Triangle-Lab-3DP/PUP-board/README.md

# PUP Project README

## Introduction

"PUP" is a control board specifically designed for MMU (Multi-Material Unit) systems like [EMU](https://github.com/DW-Tas/EMU) , where each channel requires an independent controller. Of course, you can use it for any other project you wish.

### Specifications

  * **Main Chip**: RP2040 133mhz.
  * **Connectivity**: Dual power connectors and dual CAN interfaces for convenient daisy-chaining.
  * **Drivers**: 1 x Onboard TMC2226 (TMC2209 in different packages) stepper driver.
  * **Dedicated Interfaces**: 1 x 8-pin XH2.54 connector is provided for direct connection to the EMU Hatch Board.
  * **Lighting**: 2 x Neo pixel RGB interfaces, one of which is integrated into the 8-pin XH2.54 connector.
  * **IO Expansion**:
      * 8 x I/O connectors, two of which are integrated into the 8-pin XH2.54 connector.
      * 3 x I2C interfaces.
      * 1 x SPI (AUX) interfaces.
  * **Outputs & Sensors**:
      * 2 x 24V Fans Output (1A max).
      * 1 x Heater output, 5A max.
      * 1 x NTC temperature sensor interface for temperature monitoring.
      * 1 x ADC pin for PSF Sensor.
  * **Power Output**: The 5V/3A output can drive larger servos.






### Simplified Wiring & Precautions

The PUP board features integrated CAN bus and power I/O ports designed for daisy-chain expansion, significantly streamlining your wiring layout.

> **⚠️ Terminating Resistor Note:**  
> The CAN bus requires a 120Ω terminating resistor connected in parallel at both ends of the link. You need to install a jumper with a 120-ohm resistor on the last PUP board; none of the intermediate ones require it.


> **⚠️ Power Limit Warning:**  
> When daisy-chaining power across multiple PUP boards, the total combined output current must never exceed **5A**. Avoid using high-power heating outputs in this configuration. If you need to drive heaters on multiple boards simultaneously, you must wire their power inputs in parallel directly to the main power supply.

## Pin Map


## Getting Started

PUP boards ship pre-flashed with the Katapult bootloader and Klipper firmware. Once the boards are correctly wired and powered on, they are ready for use, and the RUN LED will remain solidly lit.

### 1\. Host Configuration

Please ensure that the CAN bus interface on your Klipper host is configured and the speed is set to 1,000,000.

### 2\. Querying UUIDs

Executing the `canbus_query` command will display the UUIDs of all connected PUP boards:

``` bash
~/klippy-env/bin/python ~/klipper/scripts/canbus_query.py can0

```


### 3\. Lane Mapping

To map a specific UUID to its physical lane (e.g., Lane 0), follow these steps:

1.  Double-click the **RST** button on the target board. The **RUN LED** will begin blinking.
 

2.  Re-run the `canbus_query` command. The application mode for this specific board's UUID will now display as **CanBoot** (or **Katapult**).
 

3.  Record this UUID, then repeat the process for the remaining boards to map every lane.

## License

This project is licensed under the MIT License - see the LICENSE file for details.
