Triangle-Lab-3DP/PUP-board/TL_PUP_v1.0b_Pin_Map.pdf

Vin
/Vout

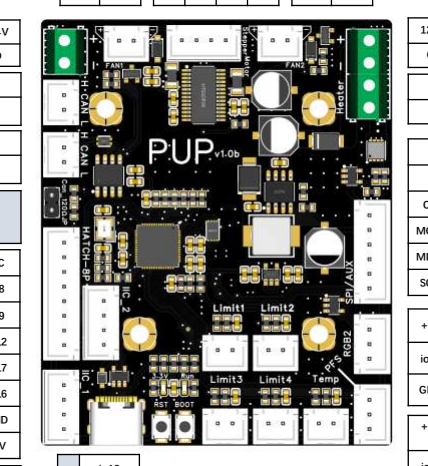
[picture p1: figure]

12-24V

GND

CAN Bus
Termination
resistor jumper

Fan1

Vin io10

Fan2

Vin io11

12-24V
Vin
/Vout GND

Vin
Heater
io20
CAN H | RX io4
CAN L | TX io5
| NC
LED | io8
PRE | io9
POST | io12
SDA | io17
SCL | io16
GND | GND
+5V | +5V IIC_1

io17

io16

GND

+5V

Limit1

io25 GND

Limit2

io24 GND

Limit3/TEMP

io26 GND

Limit4/TEMP

io26 GND

TEMP

io28 GND

IIC_2

io18

io19

GND

+5V

GND

+5V

SPI/AUX
CS | io1
MOSI | io0
MISO | io3
SCK | io2

+5V

RGB2
io23

GND

+3.3 V

PFS in
io29

GND

TMC2209 Driver

EN | io7
DIR | io6
STEP | io15
UART | io13

Stepper Motor

A1 | A2 | B1 | B2
CAN H | RX io4
CAN L | TX io5

# PUP v1.0b Pin out
