Triangle-Lab-3DP/PUP-board/3D CAD/TL_PUP_IO_Board_for_EMU/TL_PUP_IO_Board_Mount_for_EMU.STEP

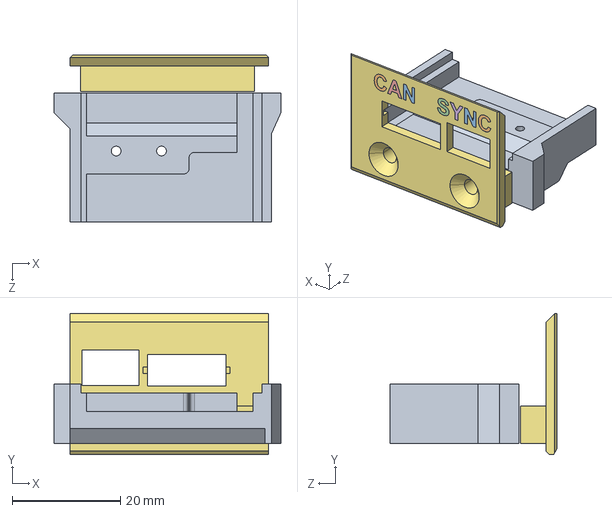
[picture p2: CAD file, 2026-07-31]
3D CAD/TL_PUP_IO_Board_for_EMU/TL_PUP_IO_Board_Mount_for_EMU.STEP
42.0 x 26.1 x 30.8 mm
[a]_Cable Entry - IO Board Inner
[a]_Cable Entry - IO Board OutSide (1)
