Triangle-Lab-3DP/PUP-board/3D CAD/TL_PUP_v1.0b_Mount_for_EMU.STEP

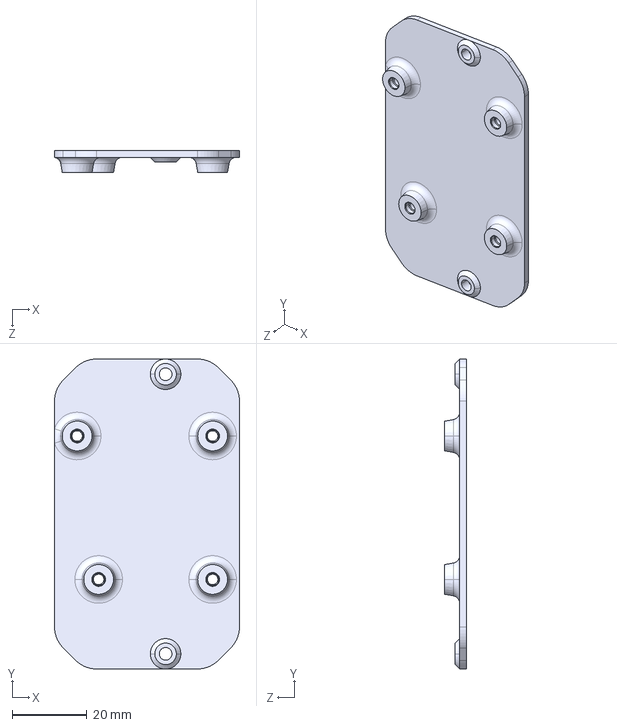
[picture p3: CAD file, 2026-07-31]
3D CAD/TL_PUP_v1.0b_Mount_for_EMU.STEP
49.6 x 83.2 x 5.80 mm
