Triangle-Lab-3DP/PUP-board/3D CAD/TL PUP board v1.0b.step

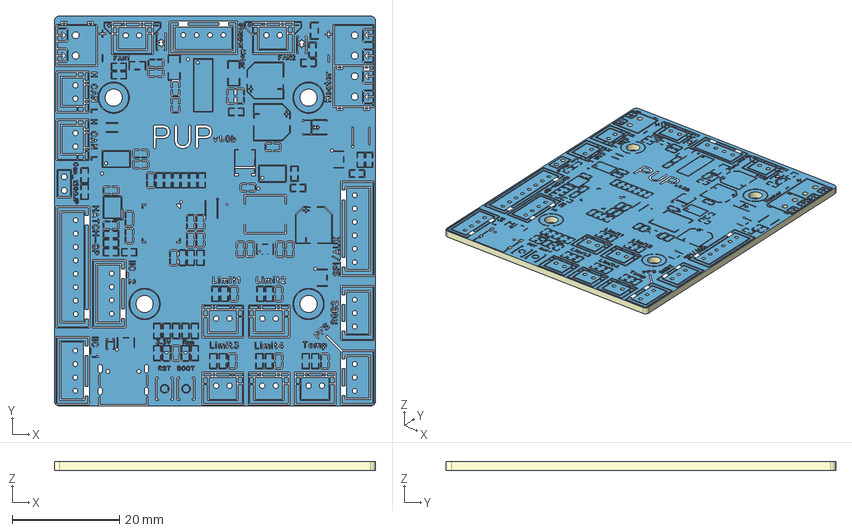
[picture p4: CAD file, 2026-07-31]
3D CAD/TL PUP board v1.0b.step
59.9 x 72.7 x 1.64 mm
Board~YmwZ
TopCopper~YmwZ
BottomCopper~YmwZ
TopSilkscreen~YmwZ x 400
BottomSilkscreen~YmwZ x 472
TopFpcStiffener~YmwZ
BottomFpcStiffener~YmwZ
