Triangle-Lab-3DP/PUP-board/3D CAD/TL_PUP_IO_Board_for_EMU/TL_PUP_IO_Board_for_EMU.step

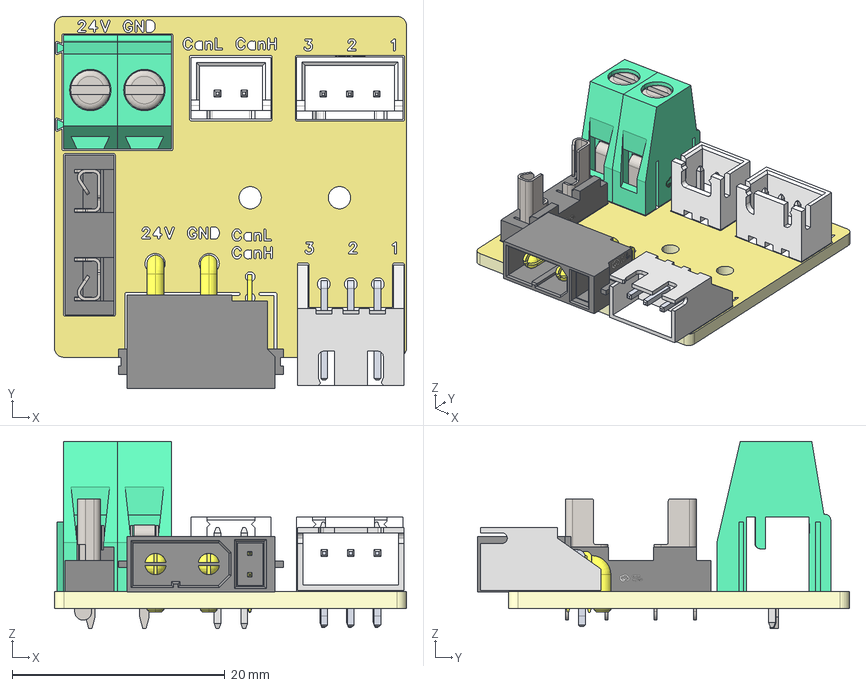
[picture p5: CAD file, 2026-07-31]
3D CAD/TL_PUP_IO_Board_for_EMU/TL_PUP_IO_Board_for_EMU.step
33.1 x 34.9 x 17.6 mm
Board~be1W
TopCopper~be1W
BottomCopper~be1W
TopSilkscreen~be1W x 41
BottomSilkscreen~be1W x 8
TopFpcStiffener~be1W
BottomFpcStiffener~be1W
CONN-TH_2P-P2.50_HX-2.54MM-2P-ZZ-MS~CONN-TH_2P-P2.50_HX-2.54MM-2P-ZZ-MS~HvNi
CONN-TH_3P-P2.50_HX25003-3WAG~CONN-TH_3P-P2.50_HX25003-3WAG~Ir1W
CONN-TH_4P-XT30PW-M~CONN-TH_4P-XT30PW-M~onUg
CONN-TH_3P-P2.50_HC-XH-3A-G~CONN-TH_3P-P2.50_HC-XH-3A-G~TdX0
FUSE-TH_XF-505P~FUSE-TH_XF-505P~nJp9
CONN-TH_P5.08_KF128-5.08-2P~CONN-TH_P5.08_KF128-5.08-2P~UoZI
