Triangle-Lab-3DP/PUP-board/Happy-Hare config/emu_macros.cfg

# === EMU Lane Temperature and Humidity Sensors ===

# AHT20 Sensor definitions below. Uncomment to enable either the BME or AHT sensor definitions depending
# on your hardware setup.
[temperature_sensor Lane_0]
sensor_type: AHT2X
aht10_report_time: 20
i2c_address: 56
i2c_mcu: mmu0
# SW I2C
i2c_software_scl_pin: mmu0:gpio16  # SLB: PB10
i2c_software_sda_pin: mmu0:gpio17  # SLB: PB11
# HW I2C
# i2c_bus: i2c3_PB3_PB4 # EBB
# i2c_bus: i2c2_PB10_PB11 # SLB

[temperature_sensor Lane_1]
sensor_type: AHT2X
aht10_report_time: 20
i2c_address: 56
i2c_mcu: mmu1
# SW I2C
i2c_software_scl_pin: mmu1:gpio16  # SLB: PB10
i2c_software_sda_pin: mmu1:gpio17  # SLB: PB11
# HW I2C
# i2c_bus: i2c3_PB3_PB4 # EBB
# i2c_bus: i2c2_PB10_PB11 # SLB

[temperature_sensor Lane_2]
sensor_type: AHT2X
aht10_report_time: 20
i2c_address: 56
i2c_mcu: mmu2
# SW I2C
i2c_software_scl_pin: mmu2:gpio16  # SLB: PB10
i2c_software_sda_pin: mmu2:gpio17  # SLB: PB11
# HW I2C
# i2c_bus: i2c3_PB3_PB4 # EBB
# i2c_bus: i2c2_PB10_PB11 # SLB

[temperature_sensor Lane_3]
sensor_type: AHT2X
aht10_report_time: 20
i2c_address: 56
i2c_mcu: mmu3
# SW I2C
i2c_software_scl_pin: mmu3:gpio16  # SLB: PB10
i2c_software_sda_pin: mmu3:gpio17  # SLB: PB11
# HW I2C
#i2c_bus: i2c3_PB3_PB4 # EBB
#i2c_bus: i2c2_PB10_PB11 # SLB

[temperature_sensor Lane_4]
sensor_type: AHT2X
aht10_report_time: 20
i2c_address: 56
i2c_mcu: mmu4
# # SW I2C
i2c_software_scl_pin: mmu4:gpio16  # SLB: PB10
i2c_software_sda_pin: mmu4:gpio17  # SLB: PB11
# # HW I2C
# # i2c_bus: i2c3_PB3_PB4 # EBB
# # i2c_bus: i2c2_PB10_PB11 # SLB

# [temperature_sensor Lane_5]
# sensor_type: AHT2X
# aht10_report_time: 20
# i2c_address: 56
# i2c_mcu: mmu5
# # SW I2C
# i2c_software_scl_pin: mmu5:PB3  # SLB: PB10
# i2c_software_sda_pin: mmu5:PB4  # SLB: PB11
# # HW I2C
# # i2c_bus: i2c3_PB3_PB4 # EBB
# # i2c_bus: i2c2_PB10_PB11 # SLB

# [temperature_sensor Lane_6]
# sensor_type: AHT2X
# aht10_report_time: 20
# i2c_address: 56
# i2c_mcu: mmu6
# # SW I2C
# i2c_software_scl_pin: mmu6:PB3  # SLB: PB10
# i2c_software_sda_pin: mmu6:PB4  # SLB: PB11
# # HW I2C
# # i2c_bus: i2c3_PB3_PB4 # EBB
# # i2c_bus: i2c2_PB10_PB11 # SLB

# [temperature_sensor Lane_7]
# sensor_type: AHT2X
# aht10_report_time: 20
# i2c_address: 56
# i2c_mcu: mmu7
# # SW I2C
# i2c_software_scl_pin: mmu7:PB3  # SLB: PB10
# i2c_software_sda_pin: mmu7:PB4  # SLB: PB11
# # HW I2C
# # i2c_bus: i2c3_PB3_PB4 # EBB
# # i2c_bus: i2c2_PB10_PB11 # SLB

# BME280 Sensor definitions below 
#[temperature_sensor Lane_0]
#sensor_type: BME280
#i2c_address: 118
#i2c_mcu: mmu0
# SW I2C
#i2c_software_scl_pin: mmu0:PB3  # SLB: PB10
#i2c_software_sda_pin: mmu0:PB4  # SLB: PB11
# HW I2C
# i2c_bus: i2c3_PB3_PB4 # EBB
# i2c_bus: i2c2_PB10_PB11 # SLB

#[temperature_sensor Lane_1]
#sensor_type: BME280
#i2c_address: 118
#i2c_mcu: mmu1
# SW I2C
#i2c_software_scl_pin: mmu1:PB3  # SLB: PB10
#i2c_software_sda_pin: mmu1:PB4  # SLB: PB11
# HW I2C
# i2c_bus: i2c3_PB3_PB4 # EBB
# i2c_bus: i2c2_PB10_PB11 # SLB

#[temperature_sensor Lane_2]
#sensor_type: BME280
#i2c_address: 118
#i2c_mcu: mmu2
# SW I2C
#i2c_software_scl_pin: mmu2:PB3  # SLB: PB10
#i2c_software_sda_pin: mmu2:PB4  # SLB: PB11
# HW I2C
# i2c_bus: i2c3_PB3_PB4 # EBB
# i2c_bus: i2c2_PB10_PB11 # SLB

#[temperature_sensor Lane_3]
#sensor_type: BME280
#i2c_address: 118
#i2c_mcu: mmu3
# SW I2C
#i2c_software_scl_pin: mmu3:PB3  # SLB: PB10
#i2c_software_sda_pin: mmu3:PB4  # SLB: PB11
# HW I2C
# i2c_bus: i2c3_PB3_PB4 # EBB
# i2c_bus: i2c2_PB10_PB11 # SLB

#[temperature_sensor Lane_4]
#sensor_type: BME280
#i2c_address: 118
#i2c_mcu: mmu4
# SW I2C
#i2c_software_scl_pin: mmu4:PB3
#i2c_software_sda_pin: mmu4:PB4 # SLB: PB11
# HW I2C
# i2c_bus: i2c3_PB3_PB4 # EBB
# i2c_bus: i2c2_PB10_PB11 # SLB

#[temperature_sensor Lane_5]
#sensor_type: BME280
#i2c_address: 118
#i2c_mcu: mmu5
# SW I2C
#i2c_software_scl_pin: mmu5:PB3  # SLB: PB10
#i2c_software_sda_pin: mmu5:PB4  # SLB: PB11
# HW I2C
# i2c_bus: i2c3_PB3_PB4 # EBB
# i2c_bus: i2c2_PB10_PB11 # SLB

#[temperature_sensor Lane_6]
#sensor_type: BME280
#i2c_address: 118
#i2c_mcu: mmu6
# SW I2C
#i2c_software_scl_pin: mmu6:PB3  # SLB: PB10
#i2c_software_sda_pin: mmu6:PB4  # SLB: PB11
# HW I2C
# i2c_bus: i2c3_PB3_PB4 # EBB
# i2c_bus: i2c2_PB10_PB11 # SLB

#[temperature_sensor Lane_7]
#sensor_type: BME280
#i2c_address: 118
#i2c_mcu: mmu7
# SW I2C
#i2c_software_scl_pin: mmu7:PB3  # SLB: PB10
#i2c_software_sda_pin: mmu7:PB4  # SLB: PB11
# HW I2C
# i2c_bus: i2c3_PB3_PB4 # EBB
# i2c_bus: i2c2_PB10_PB11 # SLB

# === MMU Fan Auto-Control Configuration ===

# === Temperature sensors ===
[temperature_sensor _Lane_0_onboard]
sensor_type: temperature_mcu
sensor_mcu: mmu0
min_temp: 0
max_temp: 130

[temperature_sensor _Lane_1_onboard]
sensor_type: temperature_mcu
sensor_mcu: mmu1
min_temp: 0
max_temp: 130

[temperature_sensor _Lane_2_onboard]
sensor_type: temperature_mcu
sensor_mcu: mmu2
min_temp: 0
max_temp: 130

[temperature_sensor _Lane_3_onboard]
sensor_type: temperature_mcu
sensor_mcu: mmu3
min_temp: 0
max_temp: 130

# [temperature_sensor _Lane_4_onboard]
# sensor_type: temperature_mcu
# sensor_mcu: mmu4
# min_temp: 0
# max_temp: 130

# [temperature_sensor _Lane_5_onboard]
# sensor_type: temperature_mcu
# sensor_mcu: mmu5
# min_temp: 0
# max_temp: 130

# [temperature_sensor _Lane_6_onboard]
# sensor_type: temperature_mcu
# sensor_mcu: mmu6
# min_temp: 0
# max_temp: 130

# [temperature_sensor _Lane_7_onboard]
# sensor_type: temperature_mcu
# sensor_mcu: mmu7
# min_temp: 0
# max_temp: 130

# === Fans ===

[fan_generic _emu_fan_0]
pin: mmu0:MMU_FAN
max_power: 0.6
kick_start_time: 0.5

[fan_generic _emu_fan_1]
pin: mmu1:MMU_FAN
max_power: 0.6
kick_start_time: 0.5

[fan_generic _emu_fan_2]
pin: mmu2:MMU_FAN
max_power: 0.6
kick_start_time: 0.5

[fan_generic _emu_fan_3]
pin: mmu3:MMU_FAN
max_power: 0.6
kick_start_time: 0.5

# [fan_generic _emu_fan_4]
# pin: mmu4:MMU_FAN
# max_power: 1
# kick_start_time: 0.5

# [fan_generic _emu_fan_5]
# pin: mmu5:MMU_FAN
# max_power: 1
# kick_start_time: 0.5

# [fan_generic _emu_fan_6]
# pin: mmu6:MMU_FAN
# max_power: 1
# kick_start_time: 0.5

# [fan_generic _emu_fan_7]
# pin: mmu7:MMU_FAN
# max_power: 1
# kick_start_time: 0.5


# === MMU Fan Auto-Control (multi-sensor / multi-fan) ===
#
# Pairs each temperature sensor with a fan by index and controls
# that fan with hysteresis based on the paired sensor.
#
# Example:
#   variable_sensors: "Lane_0_onboard,Lane_0_onboard"
#   variable_fans:    "mmu_fan_0,mmu_fan_1"
#
# Notes:
# - Lists must be comma-separated names (no spaces, or strip spaces).
# - If list lengths differ, the shorter length is used (index pairing).
# - FORCE (below) is global: affects all listed fans.

[gcode_macro MMU_FAN_CFG]
description: Holds configuration/state for multi fan controller.
variable_on_temp: 42
variable_off_temp: 40
variable_poll_s: 5.0
variable_enabled: True
variable_forced: -1                 # -1=AUTO, 0=all OFF, 1=all ON (global)
variable_sensors: "_Lane_0_onboard,_Lane_1_onboard,_Lane_2_onboard,_Lane_3_onboard"   #_Lane_4_onboard,_Lane_5_onboard,_Lane_6_onboard,_Lane_7_onboard"   # Comma-separated temperature_sensor names
variable_fans:    "_emu_fan_0,_emu_fan_1,_emu_fan_2,_emu_fan_3"  #_emu_fan_4,_emu_fan_5,_emu_fan_6,_emu_fan_7  # Comma-separated fan_generic names
variable_warned_len_mismatch: False # internal: warn once per enable
gcode:

[gcode_macro MMU_FAN_MONITOR_ENABLE]
description: Enable automatic multi-fan control.
gcode:
  SET_GCODE_VARIABLE MACRO=MMU_FAN_CFG VARIABLE=enabled VALUE=True
  UPDATE_DELAYED_GCODE ID=_MMU_FAN_LOOP DURATION=0.1
  RESPOND TYPE=echo MSG="MMU multi-fan monitor ENABLED"

[gcode_macro MMU_FAN_MONITOR_DISABLE]
description: Disable automatic control and switch all fans OFF.
gcode:
  SET_GCODE_VARIABLE MACRO=MMU_FAN_CFG VARIABLE=enabled VALUE=False
  UPDATE_DELAYED_GCODE ID=_MMU_FAN_LOOP DURATION=0
  {% set cfg = printer["gcode_macro MMU_FAN_CFG"] %}
  {% set fans = (cfg.fans|string).replace(' ','').split(',') %}
  {% for f in fans %}
    {% if f|length > 0 %}
      SET_FAN_SPEED FAN={f} SPEED=0.0
    {% endif %}
  {% endfor %}
  RESPOND TYPE=echo MSG="MMU multi-fan monitor DISABLED and all fans OFF"

[gcode_macro MMU_FAN_FORCE]
description: Global manual override for all configured fans.
# Usage:
#   MMU_FAN_FORCE S=1   -> Force ALL ON
#   MMU_FAN_FORCE S=0   -> Force ALL OFF
#   MMU_FAN_FORCE S=-1  -> Return to AUTO (per-sensor hysteresis)
gcode:
  {% set s = params.S|default(-1)|int %}
  {% if s not in [-1,0,1] %}
    RESPOND TYPE=error MSG="MMU_FAN_FORCE: S must be -1, 0, or 1"
  {% else %}
    SET_GCODE_VARIABLE MACRO=MMU_FAN_CFG VARIABLE=forced VALUE={s}
    {% set cfg = printer["gcode_macro MMU_FAN_CFG"] %}
    {% set fans = (cfg.fans|string).replace(' ','').split(',') %}
    {% if s == 1 %}
      {% for f in fans %}
        {% if f|length > 0 %}
          SET_FAN_SPEED FAN={f} SPEED=1.0
        {% endif %}
      {% endfor %}
      RESPOND TYPE=echo MSG="MMU fans FORCED ON"
    {% elif s == 0 %}
      {% for f in fans %}
        {% if f|length > 0 %}
          SET_FAN_SPEED FAN={f} SPEED=0.0
        {% endif %}
      {% endfor %}
      RESPOND TYPE=echo MSG="MMU fans FORCED OFF"
    {% else %}
      RESPOND TYPE=echo MSG="MMU fans returned to AUTO mode"
    {% endif %}
  {% endif %}

[delayed_gcode _MMU_FAN_LOOP]
initial_duration: 1
gcode:
  {% set cfg = printer["gcode_macro MMU_FAN_CFG"] %}
  {% if cfg.enabled %}
    {% set forced  = cfg.forced|int %}
    {% set on_t    = cfg.on_temp|float %}
    {% set off_t   = cfg.off_temp|float %}
    {% set sensors = (cfg.sensors|string).replace(' ','').split(',') %}
    {% set fans    = (cfg.fans|string).replace(' ','').split(',') %}
    {% set n_s     = sensors|length %}
    {% set n_f     = fans|length %}
    {% set n_min   = (n_s if n_s < n_f else n_f)|int %}

    {% if n_s != n_f and (not (cfg.warned_len_mismatch|default(False))) %}
      RESPOND TYPE=echo MSG={"MMU_FAN: sensor/fan list length mismatch"}
      SET_GCODE_VARIABLE MACRO=MMU_FAN_CFG VARIABLE=warned_len_mismatch VALUE=True
    {% endif %}

    {% if forced == 1 %}
      {% for i in range(0, n_min) %}
        {% set f = fans[i] %}
        {% if f|length > 0 %}
          SET_FAN_SPEED FAN={f} SPEED=1.0
        {% endif %}
      {% endfor %}
    {% elif forced == 0 %}
      {% for i in range(0, n_min) %}
        {% set f = fans[i] %}
        {% if f|length > 0 %}
          SET_FAN_SPEED FAN={f} SPEED=0.0
        {% endif %}
      {% endfor %}
    {% else %}
      {% for i in range(0, n_min) %}
        {% set s_name = sensors[i] %}
        {% set f = fans[i] %}
        {% if s_name|length > 0 and f|length > 0 %}
          {% set t = printer["temperature_sensor " ~ s_name].temperature|float %}
          {% set cur_speed = (printer["fan_generic " ~ f].speed|default(0.0))|float %}
          {% set cur_state = 1 if cur_speed >= 0.5 else 0 %}
          {% if cur_state == 0 %}
            {% set target_state = 1 if t >= on_t else 0 %}
          {% else %}
            {% set target_state = 1 if t > off_t else 0 %}
          {% endif %}
          {% if target_state != cur_state %}
            {% if target_state == 1 %}
              SET_FAN_SPEED FAN={f} SPEED=1.0
            {% else %}
              SET_FAN_SPEED FAN={f} SPEED=0.0
            {% endif %}
          {% endif %}
        {% endif %}
      {% endfor %}
    {% endif %}

    UPDATE_DELAYED_GCODE ID=_MMU_FAN_LOOP DURATION={cfg.poll_s}
  {% endif %}

# Happy Hare LED additions

[mmu_led_effect mmu_static_white_dim]
define_on:    gates,exit
layers:       static 0 0 top (0.5,0.5,0.5, 0.5)

[mmu_led_effect mmu_static_white]
define_on:    gates,exit
layers:       static 0 0 top (1.0,1.0,1.0, 1.0)

[mmu_led_effect mmu_static_red]
define_on:    gates,exit
layers:       static 0 0 top (0.5,0.0,0.0)

[mmu_led_effect mmu_clockwise_slow]
define_on:    gates
layers:       chase  .5 .5 top    (1,1,1,1), (0.4,0.4,0.4,0.4)

[mmu_led_effect mmu_clockwise_fast]
define_on:    gates
layers:       chase  1  .5 top    (1,1,1,1), (0.4,0.4,0.4,0.4)

[mmu_led_effect mmu_anticlock_slow]
define_on:    gates
layers:       chase  -.5 .5 top   (1,1,1,1), (0.4,0.4,0.4,0.4)

[mmu_led_effect mmu_anticlock_fast]
define_on:    gates
layers:       chase  -1  .5 top   (1,1,1,1), (0.4,0.4,0.4,0.4)


## Test load/unload on specified gates with optional temporary speed/accel overrides
[gcode_macro EMU_SPEED_TEST]
description: Test load/unload on specified gates with optional temporary speed/accel overrides. If a speed/accel combination causes the EMU to stall, you have to use the e-stop to terminate the iterations, else you will grind filament.
gcode:
  # Params:
  #   GATES      - comma-separated gates (default "0")
  #   ITERATIONS - cycles per gate (default 1)
  #   SPEED      - override for BOTH gear_from_spool_speed & gear_unload_speed
  #   ACCEL      - override for BOTH gear_from_spool_accel & gear_unload_accel
  {% set GATES = params.GATES|default("0")|string %}
  {% set ITERATIONS = params.ITERATIONS|default(1)|int %}
  {% set tools = GATES.split(",") %}

  # --- Snapshot current [mmu] values ---
  {% set _mmu = printer.configfile.settings.mmu %}
  {% set save_gfss = _mmu.gear_from_spool_speed|float %}
  {% set save_gfsa = _mmu.gear_from_spool_accel|float %}
  {% set save_gus  = _mmu.gear_unload_speed|float %}
  {% set save_gua  = _mmu.gear_unload_accel|float %}

  # --- Determine overrides (fallback to current if not supplied) ---
  {% set OV_SPEED = params.SPEED|default(save_gfss)|float %}
  {% set OV_ACCEL = params.ACCEL|default(save_gfsa)|float %}

  {% if (tools|length > 0) and (ITERATIONS > 0) %}
      M400
      RESPOND TYPE=echo MSG="EMU_SPEED_TEST: Starting. Gates={GATES}, Iterations={ITERATIONS}."
      RESPOND TYPE=echo MSG="EMU_SPEED_TEST: Applying overrides -> Speed={OV_SPEED}, Accel={OV_ACCEL}."
      M400

      # Apply temporary overrides
      mmu_test_config gear_from_spool_speed={OV_SPEED} gear_from_spool_accel={OV_ACCEL} gear_unload_speed={OV_SPEED} gear_unload_accel={OV_ACCEL} quiet=1

      # --- Main test loops ---
      {% for tool in tools %}
         {% set tool_trim = tool|trim %}
         {% for i in range(ITERATIONS) %}
            {% set i1 = i + 1 %}
            M400
            RESPOND TYPE=echo MSG="EMU_SPEED_TEST: Gate {tool_trim} • Iteration {i1}/{ITERATIONS} • Speed={OV_SPEED} • Accel={OV_ACCEL}."
            M400
            MMU_SELECT TOOL={tool_trim}
            _MMU_STEP_LOAD_BOWDEN
            _MMU_STEP_UNLOAD_BOWDEN
            mmu_check_gate
         {% endfor %}
         mmu_recover
         mmu_unload
         mmu_check_gate
      {% endfor %}

      # --- Restore original values ---
      M400
      RESPOND TYPE=echo MSG="EMU_SPEED_TEST: Restoring original MMU values -> Speed(from_spool)={save_gfss}, Accel(from_spool)={save_gfsa}, Speed(unload)={save_gus}, Accel(unload)={save_gua}."
      M400
      mmu_test_config gear_from_spool_speed={save_gfss} gear_from_spool_accel={save_gfsa} gear_unload_speed={save_gus} gear_unload_accel={save_gua} quiet=1

      M400
      RESPOND TYPE=echo MSG="EMU_SPEED_TEST: Done."
      M400
  {% else %}
      M400
      RESPOND TYPE=echo MSG="EMU_SPEED_TEST: Gate(s) not provided or iterations < 1."
      M400
  {% endif %}


###########################################################################
# Convenience macro that runs MMU_CALIBRATE_BOWDEN for every gate in turn,
# instead of having to select each gate and re-issue the command manually.
#
# Parameters (all optional):
#   BOWDEN_LENGTH=<float>   Approximate bowden length passed to every gate.
#                           Must be slightly MORE than the real bowden length.
#                           Defaults to the firmware's bowden_homing_max.
#   SAVE=0|1                Persist results to mmu_vars.cfg (default: 1).
#   START_GATE=<int>        First gate to calibrate (default: 0). Useful for
#                           resuming after a failure.
#   END_GATE=<int>          Last gate to calibrate inclusive
#                           (default: num_gates - 1).
#
# Notes:
# - MMU must be homed and unloaded before running.
# - Requires an extruder homing sensor (PSF/Compression/Extruder entry)
# - Only gates whose printer.mmu.gate_status is 1 (AVAILABLE) or 2
#   (AVAILABLE_FROM_BUFFER) are calibrated. Empty (0) and unknown (-1) gates
#   are skipped automatically.
# - For MMUs configured with variable_bowden_lengths=0 the bowden length is
#   shared across all gates, so only gate 0 is calibrated and the macro will
#   tell you so and exit.
###########################################################################
[gcode_macro MMU_CALIBRATE_BOWDENS]
description: Calibrate bowden length for every gate (loops MMU_CALIBRATE_BOWDEN)
gcode:
    {% set num_gates       = printer.mmu.num_gates|int %}
    {% set variable_bl     = printer.configfile.settings.mmu_machine.variable_bowden_lengths|default(1)|int %}
    {% set start_gate      = params.START_GATE|default(0)|int %}
    {% set end_gate        = params.END_GATE|default(num_gates - 1)|int %}
    {% set bowden_length   = params.BOWDEN_LENGTH|default('')|string %}
    {% set save            = params.SAVE|default(1)|int %}

    {% if not printer.mmu.enabled %}
        {action_raise_error("MMU is disabled. Run MMU ENABLE=1 first")}
    {% endif %}
    {% if not printer.mmu.is_homed %}
        {action_raise_error("MMU must be homed before bulk bowden calibration. Run MMU_HOME")}
    {% endif %}
    {% if printer.mmu.filament_pos != 0 %}
        {action_raise_error("Filament must be unloaded (filament_pos=0) before bulk bowden calibration")}
    {% endif %}
    {% if start_gate < 0 or start_gate >= num_gates %}
        {action_raise_error("START_GATE=%d out of range (0..%d)" % (start_gate, num_gates - 1))}
    {% endif %}
    {% if end_gate < start_gate or end_gate >= num_gates %}
        {action_raise_error("END_GATE=%d out of range (%d..%d)" % (end_gate, start_gate, num_gates - 1))}
    {% endif %}

    # When variable_bowden_lengths is disabled only gate 0 has any effect
    {% if variable_bl == 0 %}
        MMU_LOG MSG="variable_bowden_lengths=0 on this MMU - all gates share gate 0's value."
        MMU_LOG MSG="Running a single calibration on gate 0 only."
        {% set end_gate = 0 %}
        {% set start_gate = 0 %}
    {% endif %}

    # Build the argument string passed to MMU_CALIBRATE_BOWDEN.
    {% set ns = namespace(extra='') %}
    {% if bowden_length != '' %}
        {% set ns.extra = ns.extra + ' BOWDEN_LENGTH=' + bowden_length %}
    {% endif %}
    {% set ns.extra = ns.extra + ' SAVE=' + save|string %}

    MMU_LOG MSG="-----------------------------------------------"
    MMU_LOG MSG="Starting bulk bowden calibration on gates {start_gate}..{end_gate}"
    MMU_LOG MSG="-----------------------------------------------"

    {% for gate in range(start_gate, end_gate + 1) %}
        {% set gate_status = printer.mmu.gate_status[gate]|int %}
        # Only calibrate gates known to have filament available:
        #   1 = GATE_AVAILABLE, 2 = GATE_AVAILABLE_FROM_BUFFER
        # Skip everything else (0=empty, -1=unknown).
        {% if gate_status not in [1, 2] %}
            MMU_LOG MSG="--> Gate {gate}: SKIPPED (gate_status={gate_status}, not AVAILABLE)"
        {% else %}
            MMU_LOG MSG="-----------------------------------------------"
            MMU_LOG MSG="--> Gate {gate}: selecting and starting calibration"
            MMU_LOG MSG="-----------------------------------------------"

            MMU_SELECT GATE={gate}
            MMU_CALIBRATE_BOWDEN{ns.extra}
        {% endif %}
    {% endfor %}

    MMU_LOG MSG="-----------------------------------------------"
    MMU_LOG MSG="Bulk bowden calibration complete."
    MMU_LOG MSG="Use MMU_STATUS to inspect resulting bowden lengths."
    MMU_LOG MSG="-----------------------------------------------"
