Triangle-Lab-3DP/PUP-board/Happy-Hare config/base/mmu_hardware.cfg

# ----------------------------------------------------------------------------
# MMU Hardware config file ---------------------------------------------------
# ----------------------------------------------------------------------------
[mmu_machine]
num_gates: 5			
mmu_vendor: EMU			
mmu_version: 1.0			

selector_type: VirtualSelector
variable_bowden_lengths: 1		
variable_rotation_distances: 1		
require_bowden_move: 1		
filament_always_gripped: 1	
has_bypass: 1 

# Add your temperature and humidity sensors here for them to be visible in mainsail. One line per lane.
# Supported in HH vesion 3.42 and above.
environment_sensors:    temperature_sensor Lane_0, 
                        temperature_sensor Lane_1,
                        temperature_sensor Lane_2,
                        temperature_sensor Lane_3,
						temperature_sensor Lane_4

# ----------------------------------------------------------------------------
# Stepper definitions --------------------------------------------------------
# ----------------------------------------------------------------------------
# Lane 0 --------------------------
[tmc2209 stepper_mmu_gear]
uart_pin: mmu0:MMU_GEAR_UART
run_current: 0.8		
hold_current: 0.10
interpolate: True
sense_resistor: 0.110	
stealthchop_threshold: 0		

[stepper_mmu_gear]
step_pin: mmu0:MMU_GEAR_STEP
dir_pin: !mmu0:MMU_GEAR_DIR
enable_pin: !mmu0:MMU_GEAR_ENABLE
rotation_distance: 22.7574		
gear_ratio: 1:1			
microsteps: 4				
full_steps_per_rotation: 200		

# Lane 1 --------------------------
[tmc2209 stepper_mmu_gear_1]
uart_pin: mmu1:MMU_GEAR_UART

[stepper_mmu_gear_1]
step_pin: mmu1:MMU_GEAR_STEP
dir_pin: !mmu1:MMU_GEAR_DIR
enable_pin: !mmu1:MMU_GEAR_ENABLE

# Lane 2 --------------------------
[tmc2209 stepper_mmu_gear_2]
uart_pin: mmu2:MMU_GEAR_UART

[stepper_mmu_gear_2]
step_pin: mmu2:MMU_GEAR_STEP
dir_pin: !mmu2:MMU_GEAR_DIR
enable_pin: !mmu2:MMU_GEAR_ENABLE

# Lane 3 --------------------------
[tmc2209 stepper_mmu_gear_3]
uart_pin: mmu3:MMU_GEAR_UART

[stepper_mmu_gear_3]
step_pin: mmu3:MMU_GEAR_STEP
dir_pin: !mmu3:MMU_GEAR_DIR
enable_pin: !mmu3:MMU_GEAR_ENABLE

# # Lane 4 --------------------------
[tmc2209 stepper_mmu_gear_4]
uart_pin: mmu4:MMU_GEAR_UART

[stepper_mmu_gear_4]
step_pin: mmu4:MMU_GEAR_STEP
dir_pin: !mmu4:MMU_GEAR_DIR
enable_pin: !mmu4:MMU_GEAR_ENABLE

# # Lane 5 --------------------------
# [tmc2209 stepper_mmu_gear_5]
# uart_pin: mmu5:MMU_GEAR_UART

# [stepper_mmu_gear_5]
# step_pin: mmu5:MMU_GEAR_STEP
# dir_pin: mmu5:MMU_GEAR_DIR
# enable_pin: !mmu5:MMU_GEAR_ENABLE

# # Lane 6 --------------------------
# [tmc2209 stepper_mmu_gear_6]
# uart_pin: mmu6:MMU_GEAR_UART

# [stepper_mmu_gear_6]
# step_pin: mmu6:MMU_GEAR_STEP
# dir_pin: mmu6:MMU_GEAR_DIR
# enable_pin: !mmu6:MMU_GEAR_ENABLE

# # Lane 7 --------------------------
# [tmc2209 stepper_mmu_gear_7]
# uart_pin: mmu7:MMU_GEAR_UART

# [stepper_mmu_gear_7]
# step_pin: mmu7:MMU_GEAR_STEP
# dir_pin: mmu7:MMU_GEAR_DIR
# enable_pin: !mmu7:MMU_GEAR_ENABLE

# ----------------------------------------------------------------------------
# Sensors definitions --------------------------------------------------------
# ----------------------------------------------------------------------------

[mmu_sensors]
pre_gate_switch_pin_0: ^mmu0:MMU_PRE_GATE
pre_gate_switch_pin_1: ^mmu1:MMU_PRE_GATE
pre_gate_switch_pin_2: ^mmu2:MMU_PRE_GATE
pre_gate_switch_pin_3: ^mmu3:MMU_PRE_GATE
pre_gate_switch_pin_4: ^mmu4:MMU_PRE_GATE
# pre_gate_switch_pin_5: ^mmu5:MMU_PRE_GATE
# pre_gate_switch_pin_6: ^mmu6:MMU_PRE_GATE
# pre_gate_switch_pin_7: ^mmu7:MMU_PRE_GATE

post_gear_switch_pin_0: ^mmu0:MMU_POST_GEAR
post_gear_switch_pin_1: ^mmu1:MMU_POST_GEAR
post_gear_switch_pin_2: ^mmu2:MMU_POST_GEAR
post_gear_switch_pin_3: ^mmu3:MMU_POST_GEAR
post_gear_switch_pin_4: ^mmu4:MMU_POST_GEAR
# post_gear_switch_pin_5: ^mmu5:MMU_POST_GEAR
# post_gear_switch_pin_6: ^mmu6:MMU_POST_GEAR
# post_gear_switch_pin_7: ^mmu7:MMU_POST_GEAR

# if you have a toolhead sensors, uncomment and insert the definitions here
#extruder_switch_pin: ^EBBCan:PB6
#toolhead_switch_pin: ^EBBCan:PB5

# Section below if using the dual switch version of the EMU Sync. Uncomment the below
# sync_feedback_tension_pin: ^mmu0:MMU_TENSION         # Compression is when you pull the bowden tubes (entry/exit) away from each other. Tension when you push the tubes together.
# sync_feedback_compression_pin: ^mmu0:MMU_COMPRESSION

# Section below if using the Proportional (PSF) version of the EMU Sync.
# Comment out/delete the dual switch section above and uncomment the section below to use.
# Dont forget to run the calibration routine (MMU_CALIBRATE_PSENSOR) and
# update the sync_feedback_analog_max_compression, sync_feedback_analog_max_tension and sync_feedback_analog_neutral_point accordingly.

#sync_feedback_analog_pin: mmu0:MMU_TH
##sync_feedback_analog_max_compression: 0.9
#sync_feedback_analog_max_tension:     0.1
#sync_feedback_analog_neutral_point:   0.5

# ----------------------------------------------------------------------------
# MMU NEOPIXEL LED SUPPORT EBB42/36 ------------------------------------------
# Delete or comment out if not using an EBB42/36 -----------------------------
# Below sample configuration is shown for printed eject button ---------------
# Update as per instructions for PCB LED eject button ------------------------
# ----------------------------------------------------------------------------

# [neopixel _mmu0_leds] # one block per lane (Lane 0)
# pin: mmu0:MMU_NEOPIXEL
# chain_count: 2	# one for the box and one for the eject button. Set to 5 for the LED PCB
# color_order: GRBW		

# [neopixel _mmu1_leds] # one block per lane (Lane 1)
# pin: mmu1:MMU_NEOPIXEL
# chain_count: 2			
# color_order: GRBW		

# [neopixel _mmu2_leds] # one block per lane (Lane 2)
# pin: mmu2:MMU_NEOPIXEL
# chain_count: 2		
# color_order: GRBW	

# [neopixel _mmu3_leds] # one block per lane (Lane 3)
# pin: mmu3:MMU_NEOPIXEL
# chain_count: 2			
# color_order: GRBW

# # [neopixel _mmu4_leds] # one block per lane (Lane 4)
# # pin: mmu4:MMU_NEOPIXEL
# # chain_count: 2			
# # color_order: GRBW

# # [neopixel _mmu5_leds] # one block per lane (Lane 5)
# # pin: mmu5:MMU_NEOPIXEL
# # chain_count: 2			
# # color_order: GRBW

# # [neopixel _mmu6_leds] # one block per lane (Lane 6)
# # pin: mmu6:MMU_NEOPIXEL
# # chain_count: 2			
# # color_order: GRBW

# # [neopixel _mmu7_leds] # one block per lane (Lane 7)
# # pin: mmu7:MMU_NEOPIXEL
# # chain_count: 2			
# # color_order: GRBW	

# [mmu_leds unit0]
# exit_leds:
#   neopixel:_mmu0_leds (1) # add/remove to match number of lanes. Set to (1,2,3,4) for the LED PCB
#   neopixel:_mmu1_leds (1)
#   neopixel:_mmu2_leds (1)
#   neopixel:_mmu3_leds (1)
# #   neopixel:_mmu4_leds (1)
# #   neopixel:_mmu5_leds (1)
# #   neopixel:_mmu6_leds (1)
# #   neopixel:_mmu7_leds (1)
# entry_leds:
#   neopixel:_mmu0_leds (2) # add/remove to match number of lanes. Set to (5) for the LED PCB
#   neopixel:_mmu1_leds (2)
#   neopixel:_mmu2_leds (2)
#   neopixel:_mmu3_leds (2)
#   neopixel:_mmu4_leds (2)
#   neopixel:_mmu5_leds (2)
#   neopixel:_mmu6_leds (2)
#   neopixel:_mmu7_leds (2)
# frame_rate: 15

# ----------------------------------------------------------------------------
# MMU NEOPIXEL LED SUPPORT Solo Lane Board (SLB) -----------------------------
# Delete or comment out if not using an SLB ----------------------------------
# Below sample configuration is shown for the PCB LED eject button -----------
# Update as per instructions for printed eject button  -----------------------
# ----------------------------------------------------------------------------

[neopixel _mmu0_leds_box] # one block per lane (Lane 1)
pin: mmu0:MMU_NEOPIXEL_BOX
chain_count: 1			# Always 1 LED for the box
color_order: GRBW

[neopixel _mmu0_leds_button] # one block per lane (Lane 1)
pin: mmu0:MMU_NEOPIXEL_BUTTON
chain_count: 4			# Set to 1 if using Neopixel eject button. Set to 4 if using LED PCB
color_order: GRBW

[neopixel _mmu1_leds_box] # one block per lane (Lane 2)
pin: mmu1:MMU_NEOPIXEL_BOX
chain_count: 1			
color_order: GRBW

[neopixel _mmu1_leds_button] # one block per lane (Lane 2)
pin: mmu1:MMU_NEOPIXEL_BUTTON
chain_count: 4			
color_order: GRBW

[neopixel _mmu2_leds_box] # one block per lane (Lane 3)
pin: mmu2:MMU_NEOPIXEL_BOX
chain_count: 1			
color_order: GRBW

[neopixel _mmu2_leds_button] # one block per lane (Lane 3)
pin: mmu2:MMU_NEOPIXEL_BUTTON
chain_count: 4			
color_order: GRBW

[neopixel _mmu3_leds_box] # one block per lane (Lane 4)
pin: mmu3:MMU_NEOPIXEL_BOX
chain_count: 1			
color_order: GRBW

[neopixel _mmu3_leds_button] # one block per lane (Lane 4)
pin: mmu3:MMU_NEOPIXEL_BUTTON
chain_count: 4			
color_order: GRBW

[neopixel _mmu4_leds_box] # one block per lane (Lane 5)
pin: mmu4:MMU_NEOPIXEL_BOX
chain_count: 1			
color_order: GRBW

[neopixel _mmu4_leds_button] # one block per lane (Lane 5)
pin: mmu4:MMU_NEOPIXEL_BUTTON
chain_count: 4			
color_order: GRBW

# [neopixel _mmu5_leds_box] # one block per lane (Lane 6)
# pin: mmu5:MMU_NEOPIXEL_BOX
# chain_count: 1			
# color_order: GRBW

# [neopixel _mmu5_leds_button] # one block per lane (Lane 6)
# pin: mmu5:MMU_NEOPIXEL_BUTTON
# chain_count: 4			
# color_order: GRBW

# [neopixel _mmu6_leds_box] # one block per lane (Lane 7)
# pin: mmu6:MMU_NEOPIXEL_BOX
# chain_count: 1			
# color_order: GRBW

# [neopixel _mmu6_leds_button] # one block per lane (Lane 7)
# pin: mmu6:MMU_NEOPIXEL_BUTTON
# chain_count: 4			
# color_order: GRBW

# [neopixel _mmu7_leds_box] # one block per lane (Lane 8)
# pin: mmu7:MMU_NEOPIXEL_BOX
# chain_count: 1			
# color_order: GRBW

# [neopixel _mmu7_leds_button] # one block per lane (Lane 8)
# pin: mmu7:MMU_NEOPIXEL_BUTTON
# chain_count: 4			
# color_order: GRBW

[mmu_leds unit0]
exit_leds:
  neopixel:_mmu0_leds_button (1,2,3,4)
  neopixel:_mmu1_leds_button (1,2,3,4)
  neopixel:_mmu2_leds_button (1,2,3,4)
  neopixel:_mmu3_leds_button (1,2,3,4)
  neopixel:_mmu4_leds_button (1,2,3,4)
#   neopixel:_mmu5_leds_button (1,2,3,4)
#   neopixel:_mmu6_leds_button (1,2,3,4)
#   neopixel:_mmu7_leds_button (1,2,3,4)
#   neopixel:_mmu8_leds_button (1,2,3,4)
entry_leds:
  neopixel:_mmu0_leds_box (1)
  neopixel:_mmu1_leds_box (1)
  neopixel:_mmu2_leds_box (1)
  neopixel:_mmu3_leds_box (1)
  neopixel:_mmu4_leds_box (1)
#   neopixel:_mmu5_leds_box (1)
#   neopixel:_mmu6_leds_box (1)
#   neopixel:_mmu7_leds_box (1)
frame_rate: 15

# ----------------------------------------------------------------------------
# MMU EFFECTS - EBB42,36 and Solo Lane Board ---------------------------------
# ----------------------------------------------------------------------------

enabled: True                           # LEDs are enabled at startup
animation: True                         # Use led-animation-effects
exit_effect: gate_status                # gate_status in the eject buttons
entry_effect: filament_color            # filament_color in the dry box LED
status_effect: off                      # no status LED is on the unit
logo_effect: (0, 0, 0)                  # no Logo LED is on the unit
white_light: (1, 1, 1)                  # RGB color for static white light
black_light: (1, 1, 1)                  # RGB color used to represent "black" filament
empty_light: (0.0, 0.0, 0.0)            # Empty gate has eject button "off"

effect_loading:            mmu_clockwise_fast, (0, 0, 0.4)
effect_loading_extruder:   mmu_clockwise_slow, (0, 0, 1)
effect_unloading:          mmu_anticlock_fast, (0, 0, 0.4)
effect_unloading_extruder: mmu_anticlock_slow, (0, 0, 1)
effect_heating:            mmu_breathing_red,       (0.3, 0, 0)
effect_selecting:          mmu_white_fast,          (0.2, 0.2, 0.2)
effect_checking:           mmu_white_fast,          (0.8, 0.8, 0.8)
effect_initialized:        mmu_rainbow,             (0.5, 0.2, 0)
effect_error:              mmu_strobe,              (1, 0, 0)
effect_complete:           mmu_sparkle,             (0.3, 0.3, 0.3)
effect_gate_selected:      mmu_static_blue,         (0, 0, 1)
effect_gate_available:     mmu_static_white_dim,    (0.3, 0.3, 0.3)
effect_gate_available_sel: mmu_static_white,        (0.75, 0.75, 0.75)
effect_gate_unknown:       mmu_static_orange,       (0.5, 0.2, 0)
effect_gate_unknown_sel:   mmu_ready_orange ,       (0.75, 0.3, 0)
effect_gate_empty:         mmu_static_black,        (0, 0, 0)
effect_gate_empty_sel:     mmu_static_red,           (0.2, 0, 0)
