Triangle-Lab-3DP/PUP-board/Happy-Hare config/base/mmu.cfg

########################################################################################################################
# Happy Hare MMU Software
#
# EDIT THIS FILE BASED ON YOUR SETUP
#
# Copyright (C) 2022-2026  moggieuk#6538 (discord)
#                          moggieuk@hotmail.com
# This file may be distributed under the terms of the GNU GPLv3 license.
#
# Goal: Happy Hare MMU hardware pin config
#
# (\_/)
# ( *,*)
# (")_(") Happy Hare Ready
#
#
# This contains aliases for pins for MCU type unknown
#
[mcu mmu0]
canbus_uuid: 0c29e4dbfa8b
canbus_interface: can0 # if you have multiple canbus buses, define here which canbus has the EMU units on it.

[mcu mmu1]
canbus_uuid: 0294ec771407
canbus_interface: can0

[mcu mmu2]
canbus_uuid: 7ea9f2c14e36
canbus_interface: can0

[mcu mmu3]
canbus_uuid: cb631bb9d0a8
canbus_interface: can0

[mcu mmu4]
canbus_uuid: ca2561cc9d0a3
canbus_interface: can0



# PIN ALIASES FOR MMU MCU BOARD ----------------------------------------------------------------------------------------
# ██████╗ ██╗███╗   ██╗     █████╗ ██╗     ██╗ █████╗ ███████╗
# ██╔══██╗██║████╗  ██║    ██╔══██╗██║     ██║██╔══██╗██╔════╝
# ██████╔╝██║██╔██╗ ██║    ███████║██║     ██║███████║███████╗
# ██╔═══╝ ██║██║╚██╗██║    ██╔══██║██║     ██║██╔══██║╚════██║
# ██║     ██║██║ ╚████║    ██║  ██║███████╗██║██║  ██║███████║
# ╚═╝     ╚═╝╚═╝  ╚═══╝    ╚═╝  ╚═╝╚══════╝╚═╝╚═╝  ╚═╝╚══════╝
# Section to create alias for pins used by MMU for easier integration into Klippain and RatOS. The names match those
# referenced in the mmu_hardware.cfg file. If you get into difficulty you can also comment out this aliases definition
# completely and configure the pin names directly into mmu_hardware.cfg. However, use of aliases is encouraged.

# Note: that aliases are not created for TOOLHEAD_SENSOR, EXTRUDER_SENSOR or SYNC_FEEDBACK_SENSORS because those are
# most likely on the printer's main mcu. These should be set directly in mmu_hardware.cfg
#
[board_pins mmu]
mcu: mmu0, mmu1, mmu2, mmu3
aliases:
    MMU_GEAR_UART=gpio13,
    MMU_GEAR_STEP=gpio15,
    MMU_GEAR_DIR=gpio6,
    MMU_GEAR_ENABLE=gpio7,
    MMU_GEAR_DIAG=gpio14,

    MMU_NEOPIXEL_BOX=gpio8,
    MMU_NEOPIXEL_BUTTON=gpio23,

    MMU_PRE_GATE=gpio9,
    MMU_POST_GEAR=gpio12,

    MMU_TENSION=, # First lane has the sync feedback sensor attached to it!
    MMU_COMPRESSION=, # First lane has the sync feedback sensor attached to it!
    MMU_TH=gpio29, # First lane has the PFS sensor attached to it!

    MMU_FAN=gpio10,
    EJECT_BUTTON=gpio24,
