Triangle-Lab-3DP/PUP-board/(commit log)

2026-07-31 Update README with PUP-board details
    Added introduction and specifications for PUP-board.
2026-07-31 Create Firmware Update Guide
    Added comprehensive firmware update guide including methods for updating via CAN Bus, direct USB flashing, and reinstalling the Katapult bootloader.
